julienlevasseur/quiberon_2026/references/Documentation/alimentation.png

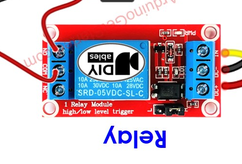
references/Documentation/alimentation.png
